stanl1y/embedded-bike/README.md

# embedded-bike
This is an arduino project. I apply several arduino modules on my bicycle to make it a safer bike. For example, there is turn signal, controable headlight with several modes, a horn, speed measurement and a lcd screen to dislay information.

This is the project report https://drive.google.com/file/d/1pjgmiW3Vc6e-MhEhwDm8MuHCR4H49vpX/view?usp=sharing
